KerJoe/RTD2662Board/TODO.txt

* Bigger potentiometer footprint ?
* Bigger footprint for 3 top Coils ?
* Replace CH341 with something else (MCP2221A ?)
* Put a diode on TX line
