KerJoe/RTD2662Board/(commit log)

2021-12-15 Revision 0.1
    [RTD2662Board.kicad_pcb, RTD2662Board.sch, RTD2662Board_CH340.sch]
2021-12-15 Revision 0.2
    [RTD2662Board-B_Cu.gbr, RTD2662Board-B_Mask.gbr, RTD2662Board-B_Paste.gbr, RTD2662Board-B_SilkS.gbr, RTD2662Board-Edge_Cuts.gbr, RTD2662Board-F_Cu.gbr, RTD2662Board-F_Mask.gbr, RTD2662Board-F_Paste.gbr]
2021-12-15 Revision 1.0
    [LVDSAdapterBoard.kicad_pcb, LVDSAdapterBoard.sch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]
2021-12-17 Added CEC pullup
    [RTD2662Board-B_Cu.gbl, RTD2662Board-B_Mask.gbs, RTD2662Board-B_SilkS.gbo, RTD2662Board-Edge_Cuts.gm1, RTD2662Board-F_Cu.gtl, RTD2662Board-F_Mask.gts, RTD2662Board-F_SilkS.gto, RTD2662Board-NPTH-drl_map.gbr]
2021-12-22 Added pull-ups to HPD transistors.
    [RTD2662Board.kicad_pcb, RTD2662Board.sch]
2021-12-28 Changed quartz footprint to allow through hole and smd.
    [RTD2662Board.kicad_pcb, RTD2662Board.sch]
2022-01-04 Silk screen fixes
    [RTD2662Board.kicad_pcb, RTD2662Board.sch]
2022-02-19 New adapter, fix incorrect power assignment of RTD2662 in the schematic
    [LVDSAdapterBoardSingle.kicad_pcb, LVDSAdapterBoardSingle.sch, RTD2662Board.kicad_pcb, RTD2662Board.sch]
2022-03-12 KiCad version update
    [LVDSAdapterBoard.kicad_pcb, LVDSAdapterBoard.kicad_sch, LVDSAdapterBoard.sch, LVDSAdapterBoardSingle.kicad_pcb, LVDSAdapterBoardSingle.kicad_sch, LVDSAdapterBoardSingle.sch, RTD2662Board.kicad_pcb, RTD2662Board.kicad_sch]
2022-04-06 Added MCP2221 patch board
    [bridgeReplacementBoard.kicad_pcb, bridgeReplacementBoard.kicad_sch]
2023-08-23 Added an extra 3.3v filtering cap, fixed label positions in schematic
    [RTD2662Board.kicad_pcb, RTD2662Board.kicad_sch]
2023-08-23 Updated schematic and render pictures
    [RTD2662Board.kicad_pcb]
2023-12-15 Replace U5, TPS61040DBV with PT4103 (White LED Step-Up Converter).
    [RTD2662Board.kicad_pcb, RTD2662Board.kicad_sch]
2023-12-15 Correct LED backlight current equation
    [RTD2662Board.kicad_sch]
2023-12-15 Update schematic picture
2023-12-15 Correct resistor value, replace connector values
    [RTD2662Board.kicad_pcb, RTD2662Board.kicad_sch]
2023-12-15 More stuff
    [RTD2662Board.kicad_sch]
2025-05-30 Update KiCAD version
    [LVDSAdapterBoard.kicad_pcb, LVDSAdapterBoard.kicad_sch, LVDSAdapterBoardSingle.kicad_pcb, LVDSAdapterBoardSingle.kicad_sch, RTD2662Board.kicad_pcb, RTD2662Board.kicad_sch]
2025-08-13 Use only the positive outputs of PAM8003 (as a unipolar amplifier), because negative outputs can't be tied together.
    [RTD2662Board.kicad_pcb, RTD2662Board.kicad_sch]
